SfaraGonzalo/20220217__UTN--PowerMeter/Documentation/Reports/IDCI_TPO_SFARA_CORRECCIONES.pdf

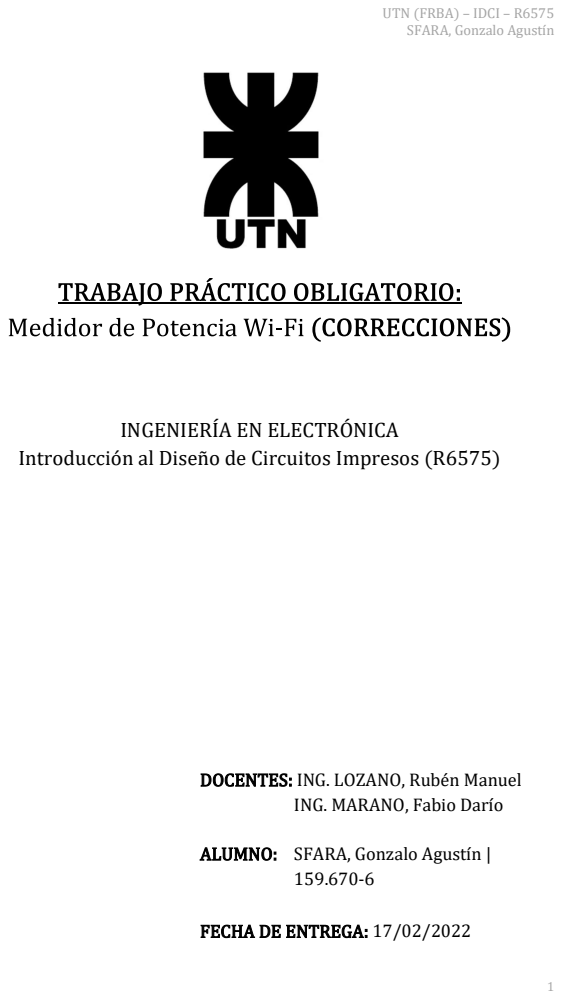
[picture p1: page 1]

UTN (FRBA) – IDCI – R6575
SFARA, Gonzalo Agustín

INGENIERÍA EN ELECTRÓNICA

Introducción al Diseño de Circuitos Impresos (R6575)

DOCENTES: ING. LOZANO, Rubén Manuel

ING. MARANO, Fabio Darío

ALUMNO: SFARA, Gonzalo Agustín

FECHA DE ENTREGA: 17/02/2022

2

ÍNDICE

3

## INTRODUCCIÓN

Se solicitaron correcciones en el proyecto entregado el 10/02/2022. Se procede a realizarlas y detallarlas en este documento.

## CORRECCIONES SOLICIDATAS

- Comprensión física del gabinete (altura del display más baja que todos los componoentes).
- Corrección del PCB footprint del display.
- Transformador y relé pegados
- Pour over all same net objects
- Signo menos capacitor
- Fuente 3V3 (Layout)
- Panelizar

## CORRECCIONES RESUELTAS

### COMPRENSIÓN FÍSICA DEL GABINETE

En la devolución del TP se plantea el conflicto de altura que se produce entre el display. La respuesta a dicho inconveniente es que:

Sí, el display debe estar a más altura que el resto de los componentes . Al confeccionar la librería de footprints de los componentes no me di cuenta de que el modelo 3D estaba quedando con una altura menor a la correspondiente. Se solucionó modificando el footprint del mismo, se detalla en el siguiente item.

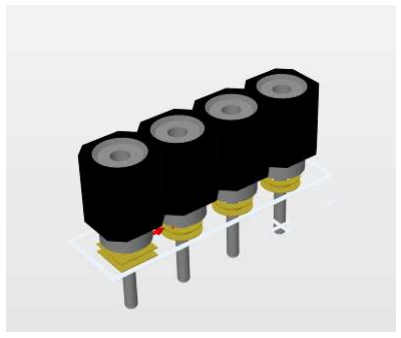
[picture p2: figure]

4

### FOOTPRINT DEL DISPLAY

En la devolución del TP se plantean varios conflictos respecto al footprint del display:
- El display se encastra en una tira de pines hembra
- Serigrafía: La tinta del layer “Top Overlay” que provoca ruido. (sugerencia del docente: “cambiar a layer mechanical”)

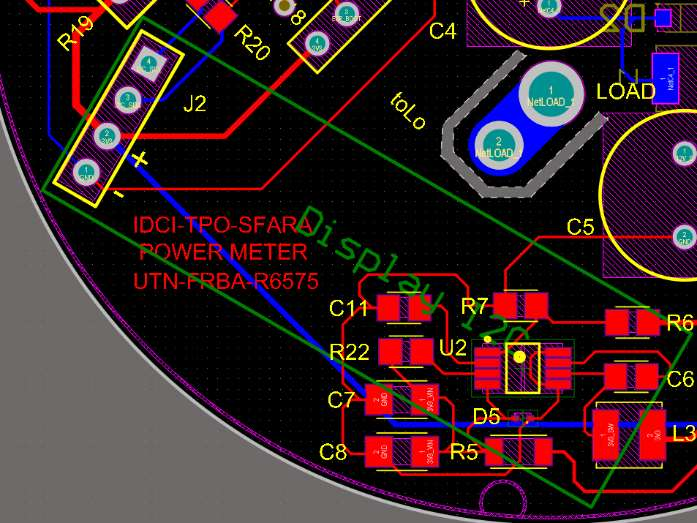
[picture p3: figure]

Se observa cómo se modificó el footprint del display. Se cambió el modelo 3D a una tira de pines hembra para “encastrar” el display, en la misma. Se dejaron los límites del display en la capa “Mechanical 15” para no interferir con el circuito de manera innecesaria.

5

### TRANSFORMADOR Y RELÉ PEGADOS

En la devolución del proyecto se indica que no entra un cable entre el relé y el transformador, debido a que estaban pegados. Se
solucionó rotando el relé y el
transformador | de | manera
opuesta, además se desplazó hacia abajo el relé. Esto provocó un espacio de 1.8mm entre el relé y el
transformador. | Tan | solo | se
necesita 1.5mm de distancia entre ellos para que entre un cable. Se podría mejorar esta distancia todavía más, si se desplazaran todos los componentes superiores hacia arriba.

### Disipación ESP-WROOM-02

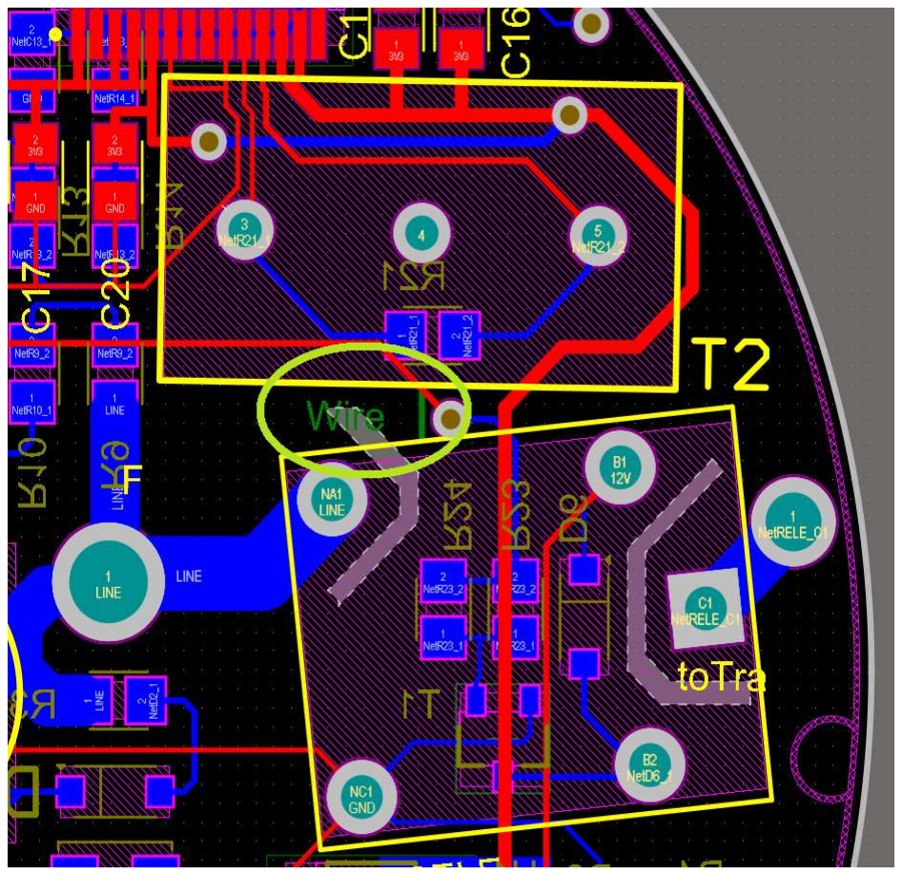
[picture p4: figure]

En la devolución del proyecto se indica que el “ground pad” debe tener contacto con el polígono de masa del “bottom layer”. Se extrae cita de la hoja de datos:

“The pad on the bottom of ESP-WROOM-02 must be provided sufficient plane contact for proper dissipation”

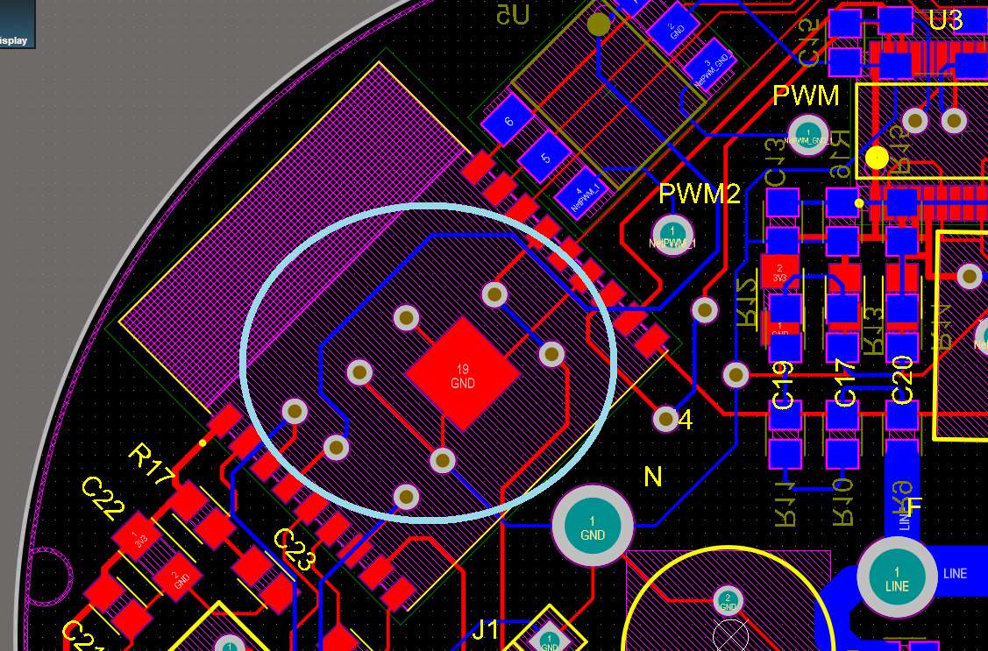
[picture p5: figure]

Se observa cómo se
agregaron vías para
una mejor disipación.
También más adelante
se | enseñará | como
queda el polígono de
masa.

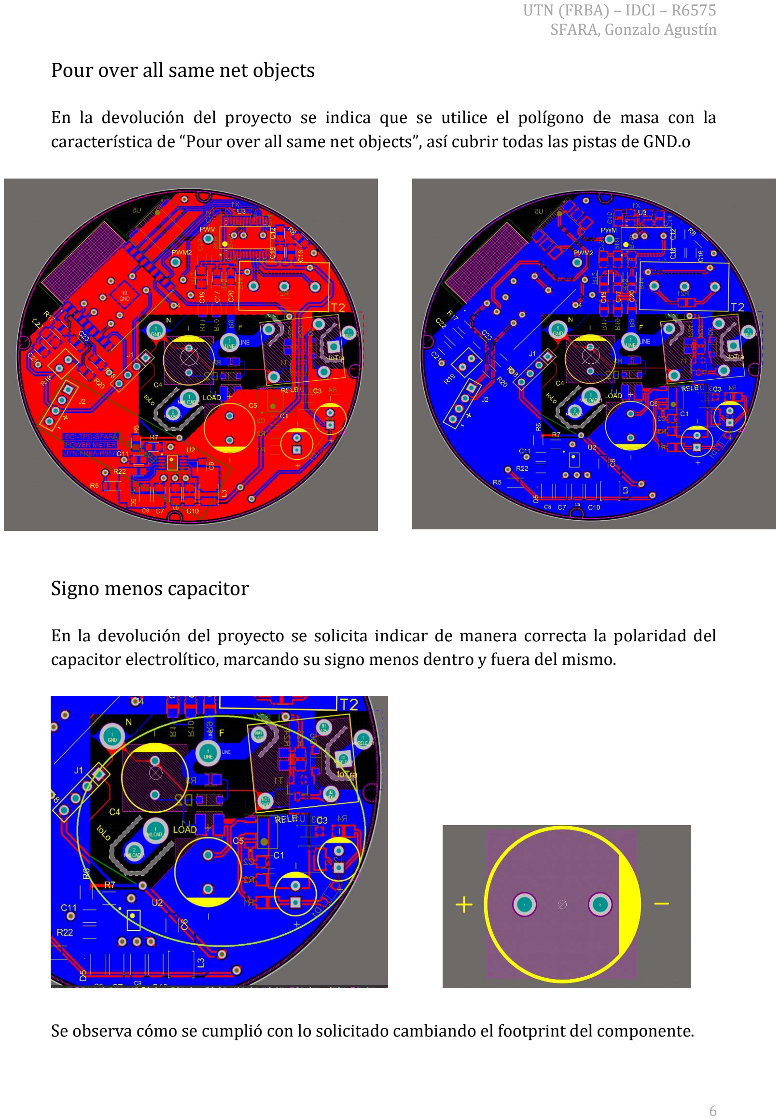
[picture p6: page 6]

6

### Pour over all same net objects

En la devolución del proyecto se indica que se utilice el polígono de masa con la característica de “Pour over all same net objects”, así cubrir todas las pistas de GND.o

### Signo menos capacitor

En la devolución del proyecto se solicita indicar de manera correcta la polaridad del capacitor electrolítico, marcando su signo menos dentro y fuera del mismo.

Se observa cómo se cumplió con lo solicitado cambiando el footprint del componente.

7

### Fuente 3V3 (Layout)

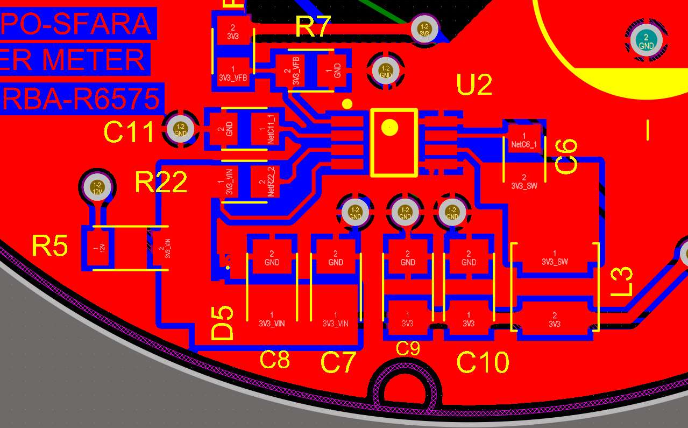
[picture p7: figure]

Se solicitó hacer un diseño de la fuente switching de 3.3V lo mas semejante al “datasheet”, priorizando:
- Polígono de capacitor de entrada corto
- Polígono de masa corto
- Polígono de salida corto
- Zona de nodo de conmutación corta

### Panelizado

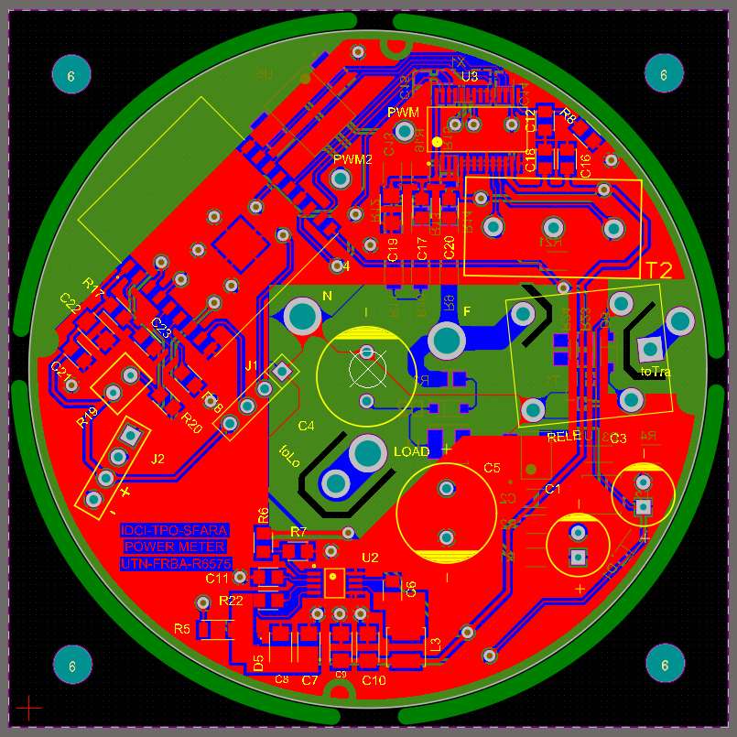
[picture p8: figure]

Se agrega panelizado al proyecto.
