SfaraGonzalo/20220217__UTN--PowerMeter/Documentation/Reports/Flujo de trabajo.pdf

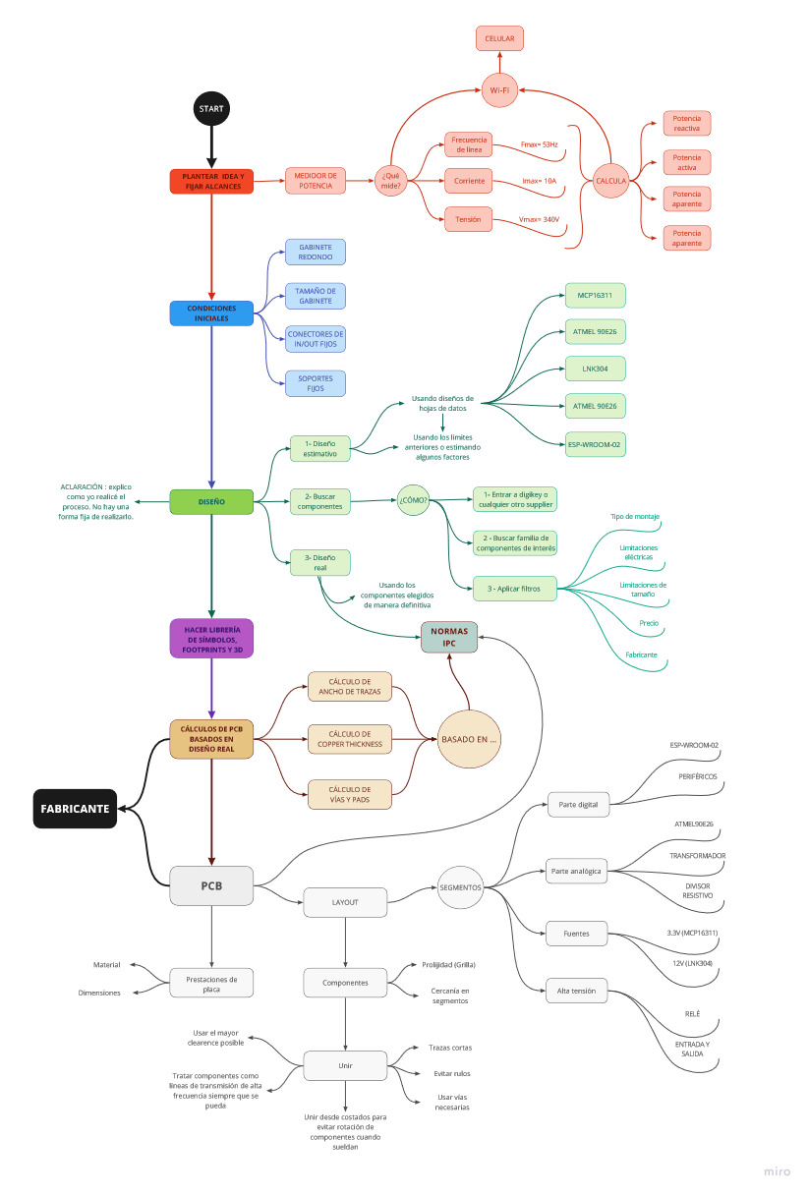
[picture p9: page 1]
