SfaraGonzalo/20220217__UTN--PowerMeter/PCB_Project/Project Outputs for PowerMeter/PowerMeter_BOM.xlsx

Comment | Description | Designator | Footprint | LibRef | Quantity | Supplier 1 | Supplier Part Number 1
CAP_P 10uF 35V | Cap Aluminum 10uF 35V 20% Radial 2000 hr 85°C Ammo Pack | C1 | CAP100RP | CAP_P | 1 | Mouser | 667-ECA-1VM100B
CAP Ceramic 0.1uF 16V X7R | Cap Ceramic 0.1uF 16V X7R 10% SMD 0805 125C Paper T/R | C2, C6, C16, C17, C20, C21, C23 | C_0805 | CAP_NP | 7 | Digi-Key | 13-CC0805KPX7R7BB104TR-ND
CAP_P 100uF 16V 20% | Cap Aluminum 100uF 16V 20% (5 X 11mm) Radial 2.5mm 180mA 2000h 85°C Ammo Pack | C3 | CAP100RP | CAP_P | 1 | Digi-Key | P10408TB-ND
CAP_P 470UF 20% 400V | CAP ALUM 470UF 20% 400V SNAP | C4 | CAP400RP | CAP_P | 1 | Digi-Key | 400USG470MEFC25X50-ND
CAP_P 470UF 20% 400V SNAP | CAP ALUM 470UF 20% 400V | C5 | CAP400RP | CAP_P | 1 | Digi-Key | 400USG470MEFC25X50-ND
CAP Ceramic 10uF 16V X7R | CL31 Series 1206 10 uF 16 V ±10% Tolerance X7R Multilayer Ceramic Capacitor | C7, C8, C19, C22 | C_1206 | CAP_NP | 4 | Future Electronics | 5039552
CAP Ceramic 10uF 16V X7R | CL31 Series 1206 10 uF 16 V ±10% Tolerance X7R Multilayer Ceramic Capacitor | C9, C10 | C_1206 | CAP_NP | 2 | Future Electronics | 5039552
CAP Ceramic 1uF 16V X7R | Cap Ceramic 1uF 16V X7R 10% Pad SMD 0805 125C T/R | C11, C18 | C_0805 | CAP_NP | 2 | RSComponents | 7665607
CAP Ceramic 33nF 16V | Multilayer Ceramic Capacitors MLCC - SMD/SMT 0805 0.033uF 10volts Y5V +80-20% | C12, C13 | C_0805 | CAP_NP | 2 | Digi-Key | VJ0805V333ZXQPW1BC-ND
Cap Cer 0805 12PF 16V | Cap Cer 0805 12PF 16V Ultra Stab | C14, C15 | C_0805 | CAP_NP | 2 | Digi-Key | C0805C120K4HAC7800-ND
DIODE | Standard Rectifier 1000V SOD-123 | D1 | SOD_123 | DIODE | 1 | Digi-Key | 1655-1N4007FLCT-ND
Standard Rectifier 1000V SOD-123 | Standard Rectifier 1000V SOD-123 | D2, D6 | SOD_123 | DIODE | 2 | Digi-Key | 1655-1N4007FLCT-ND
DIODE 1N4007FLTR | Standard Rectifier 1000V SOD-123 | D3 | SOD_123 | DIODE | 1 | Digi-Key | 1655-1N4007FLCT-ND
DIODE_TVS - VTVS12ASMF-M3-18 | Esd Protection Diode Smf Do219Ab5%; 12.4V; ir0.05 A; ip19.5A; p400W; cd807Pf | D5 | SOD_923 | DIODE_TVS | 1 | Digi-Key | VTVS12ASMF-M3-18-ND
Conector x4 - Tira de pines | Conector x4 - Tira de pines | J1 | Tira de pinesx4 | Conector x4 | 1
Display I2C 128X32 White Graphic Oled | Display I2C 128X32 White Graphic Oled | J2 | SSD1306 | Display I2C | 1 | Digi-Key | 2632-O12832A-GW-TW3-ND
INDUCTOR RLH0912-102KL | Magnetics - Fixed Inductor Through Hole / Bulk, Bag Packaging Rohs Compliant: Yes | L1 | LQH44 | INDUCTOR | 1 | Mouser | 652-RLH0912-102KL
INDUCTOR AIUR-16-152K | Inductor Power Unshielded Drum Core 1500uH 10% 10KHz Ferrite 0.15A 3.5Ohm DCR RDL Box | L2 | LQH44 | INDUCTOR | 1 | Digi-Key | AIUR-16-152K-ND
INDUCTOR LQH44PN220MJ0L | Inductor Power Chip Shielded Wirewound 22uH 20% 100KHz Ferrite 0.55A 0.576Ohm DCR 1515 T/R | L3 | LQH44 | INDUCTOR | 1 | Digi-Key | 490-7775-1-ND
RES 13K Ohm 1% 1/8W | Res Thick Film 0805 13K Ohm 1% 1/8W ±100ppm/°C Molded SMD SMD Paper T/R | R1 | R_0805 | RES | 1 | Digi-Key | RMCF0805FG13K0-ND
RES 2.05K Ohm 1% 1/8W | Res Thick Film 0805 2.05K Ohm 1% 1/8W ±200ppm/°C Molded SMD SMD Paper T/R | R2 | R_0805 | RES | 1 | Digi-Key | RMCF0805FG2K05-ND
RES 0805 8.2 Ohm 1W | Res Thin Film 0805 8.2 Ohm 1% 1W ±100ppm/C Pad SMD T/R | R3 | R_0805 | RES | 1 | Digi-Key | 764-1235-1-ND
RES 3.3 K Ohms 0.125W; +/-5% | Resistor, Thick Film Chip; 3.3 K Ohms; Case 0805; 0.125W; +/-5%; SMD; 200ppm/K; 150V | R4 | R_0805 | RES | 1 | Arrow Electronics | CRCW08053K30JNTA
POLYSWITCH MF-MSMF020-2 | PTC Resettable Fuse 0.2A(hold) 0.4A(trip) 30V 80A 0.8W 0.06s 0.4Ohm SMD Solder Pad 1812 T/R Automotive | R5 | NANOSMDC | POLYSWITCH | 1 | RSComponents | 6478140
RES 31.2K Ohm 1% 1/8W | Res 31.2K Ohm 1% 1/8W 0805 | R6 | R_0805 | RES | 1 | Digi-Key | 2019-RN73R2ATTD3122F100CT-ND
RES 10K Ohm 1% 1/8W | Res Thick Film 0805 10K Ohm 5% 1/8W ±200ppm/°C Molded SMD SMD Paper T/R | R7 | R_0805 | RES | 1 | Future Electronics | 2941144
RES 1kOhm 5% 1/8W | Anti-Sulfurated Chip Resistor Thick Film 0805 1kOhm 5% Paper T/R | R8 | R_0805 | RES | 1 | Digi-Key | AF0805JR-071KL-ND
RES 120kOhm 5% 1/8W | Chip Resistor Automotive Grade Thick Film 0805 120kOhm 5% Paper T/R, Anti-Sulfurated Chip Resistor Thick Film 0805 1kOhm 5% Paper T/R | R9, R10, R11, R12, R13, R14, R15, R16, R20 | R_0805 | RES | 9 | Arrow Electronics, Digi-Key | AC0805JR-07120KL, AF0805JR-071KL-ND
RES 10kOhm 5% 1/8W | Res Thick Film 0805 10K Ohm 5% 1/8W ±200ppm/°C Molded SMD SMD Paper T/R | R17, R18, R23, R24 | R_0805 | RES | 4 | Future Electronics | 2941144
LDR 200 Kohm, 80MW | 200 Kohm, 80MW | R19 | LDR | LDR | 1 | Newark | 87X9694
RES 100Ohm 5% 1/8W | Anti-Sulfurated Chip Resistor Thick Film 0805 100Ohm 5% Paper T/R | R21 | R_0805 | RES | 1 | Digi-Key | AF0805JR-07100RL-ND
RES 1M Ohm 1% 1/8W | Res Thick Film 0805 1M Ohm 1% 1/8W ±200ppm/°C Molded SMD Paper T/R | R22 | R_0805 | RES | 1 | Digi-Key | 311-1MNGCT-ND
Relay; 10 A; 12 VDC; PCB; PC Board; SPST-NO; 320 Ohms; 450 mW (Nom.) T77V1D10-12 | Relay; 10 A; 12 VDC; PCB; PC Board; SPST-NO; 320 Ohms; 450 mW (Nom.) | RELE | RELE SERIE 964 | RELE SIMPLE | 1 | Digi-Key | T77V1D10-12-ND
TRANSISTOR NPN | ZXTN08400BFF Series NPN 400 V 500 mA 1.5 W Transistor SMT - SOT-23F | T1 | SOT23 | TRANSISTOR NPN | 1 | RSComponents | 7115115
Current Transformer | Current Transformer | T2 | CT | CT | 1
LNK304 | AC to DC Switching Converter Buck 70kHz T/R 7-Pin SO-C | U1 | LNK304 | LNK304 | 1 | Digi-Key | 596-1129-1-ND
STEP-DOWN REGULATOR MCP16311-E/MS-ND | Regulador switching step-down | U2 | MCP16311/2 | MCP16311/2 | 1 | Digi-Key | MCP16311-E/MS-ND
ATMEL90E26 | M90E26: 3.6 V Single-Phase High-Performance Wide-Span Energy Metering IC-SSOP-28 | U3 | ATMEL90E26 | ATMEL90E26 | 1 | Newark | 67X3998
ESP-WROOM-02D | Wi-Fi Module ESP8266EX SPI 2MB Flash UART w/ Antenna | U4 | ESP-WROOM-02D | ESP-WROOM-02D | 1 | Digi-Key | 1904-1021-1-ND
OPTOACOPLADOR H11L1S1(TA) | Optocoupler Logic-Out DC-IN 1-CH 6-Pin SOIC T/R | U5 | OPTO GULLWINGx6 | OPTOACOPLADOR | 1 | Digi-Key | H11L1S1(TA)-ND
Crystal 8.192MHz ±30ppm | Crystal 8.192MHz ±30ppm (Tol) ±50ppm (Stability) 12pF FUND 100Ohm Automotive 2-Pin Mini-CSMD T/R | X1 | ABM3C | CRYSTAL_4P | 1 | Digi-Key | XC3145CT-ND
