SfaraGonzalo/20220217__UTN--PowerMeter/Models/ESP-WROOM-02D--3DModel-STEP-56544.STEP

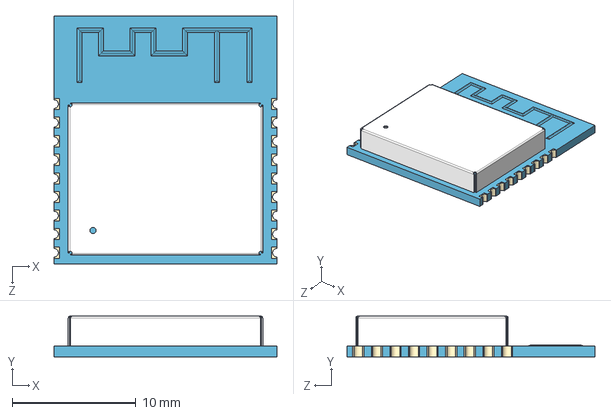
[picture p10: CAD file, 2022-11-26]
Models/ESP-WROOM-02D--3DModel-STEP-56544.STEP
18.0 x 3.30 x 20.0 mm
