SfaraGonzalo/20220217__UTN--PowerMeter/Models/PBS1.27-5.step

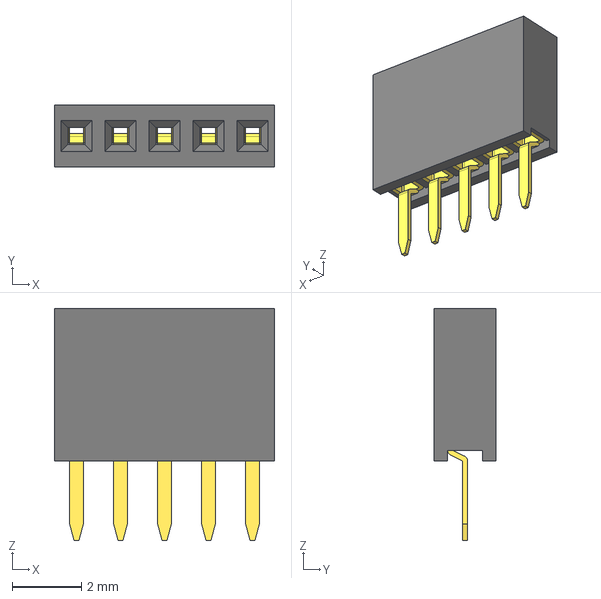
[picture p11: CAD file, 2022-11-26]
Models/PBS1.27-5.step
6.35 x 1.80 x 6.70 mm
