SfaraGonzalo/20220217__UTN--PowerMeter/Models/128x32-OLED.STEP

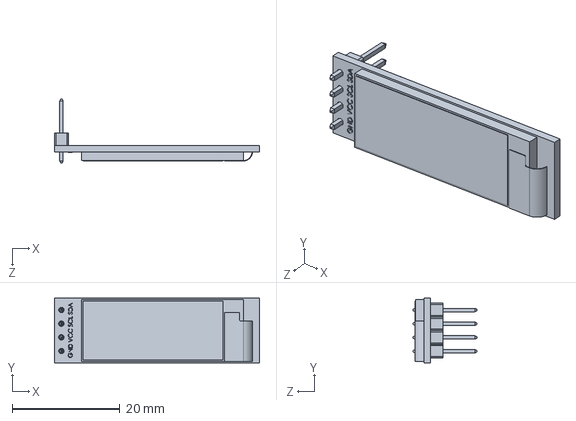
[picture p12: CAD file, 2022-11-26]
Models/128x32-OLED.STEP
38.0 x 12.0 x 11.9 mm
