SfaraGonzalo/20220217__UTN--PowerMeter/Models/female rounded header.stp

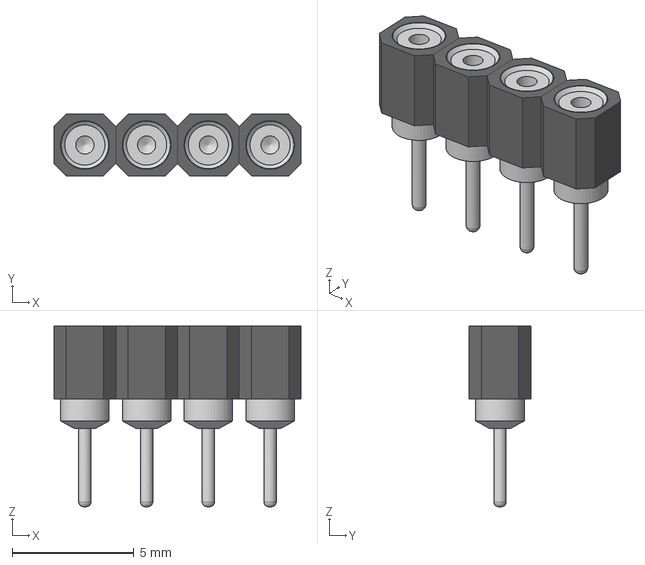
[picture p13: CAD file, 2022-11-26]
Models/female rounded header.stp
10.2 x 2.54 x 7.43 mm
