SfaraGonzalo/20220217__UTN--PowerMeter/Models/LDR-GL5516.step

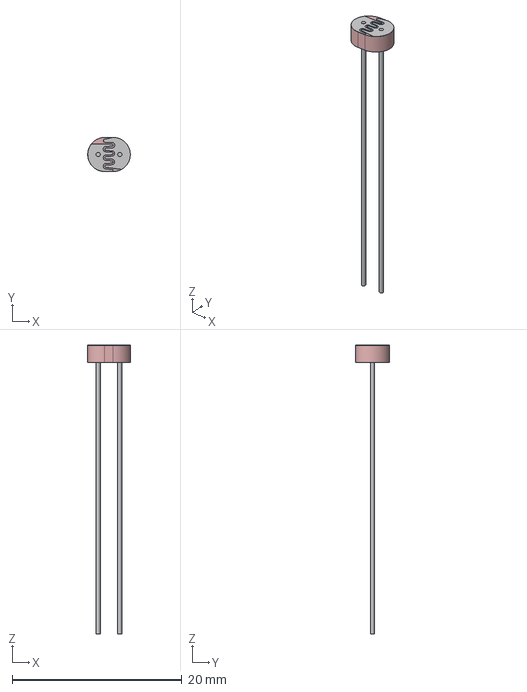
[picture p14: CAD file, 2022-11-26]
Models/LDR-GL5516.step
5.02 x 4.02 x 34.0 mm
