SfaraGonzalo/20220217__UTN--PowerMeter/Models/zmct103c.stp

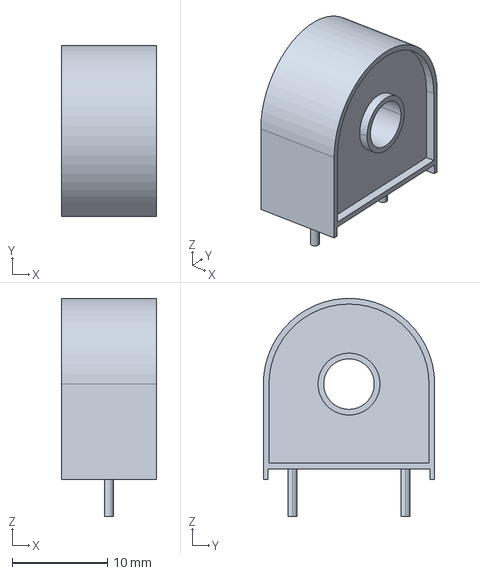
[picture p15: CAD file, 2022-11-26]
Models/zmct103c.stp
10.0 x 18.0 x 22.9 mm
