SfaraGonzalo/20220217__UTN--PowerMeter/(list of files, drawings)

Other design files:
Librerías/Basics.PcbLib
Librerías/Basics.SchLib
Librerías/Displays.PcbLib
Librerías/Displays.SchLib
Librerías/Microchip.PcbLib
Librerías/Microchip.SchLib
Librerías/Transistors.PcbLib
Librerías/Transistors.SchLib
Models/ESP-WROOM-02D/ESP-WROOM-02D.SchLib
Models/ESP-WROOM-02D/MODULE_ESP-WROOM-02D.PcbLib
PCB_Project/PowerMeter.PcbLib
PCB_Project/PowerMeter.PrjPcb
PCB_Project/PowerMeter.SchLib
PCB_Project/PowerMeter_BLK.SchDoc
PCB_Project/PowerMeter_Cpu.SchDoc
PCB_Project/PowerMeter_Meter.SchDoc
PCB_Project/PowerMeter_Panel.PcbDoc
PCB_Project/PowerMeter_Peripherics.SchDoc
PCB_Project/PowerMeter_PowerSupply.SchDoc
